RoboticsBrno/RB3201-RBControl/ele/MotorEncoder/v1.1/MotorEncoder.brd

## EAGLE design ele/MotorEncoder/v1.1/MotorEncoder.brd (2018-06-25)

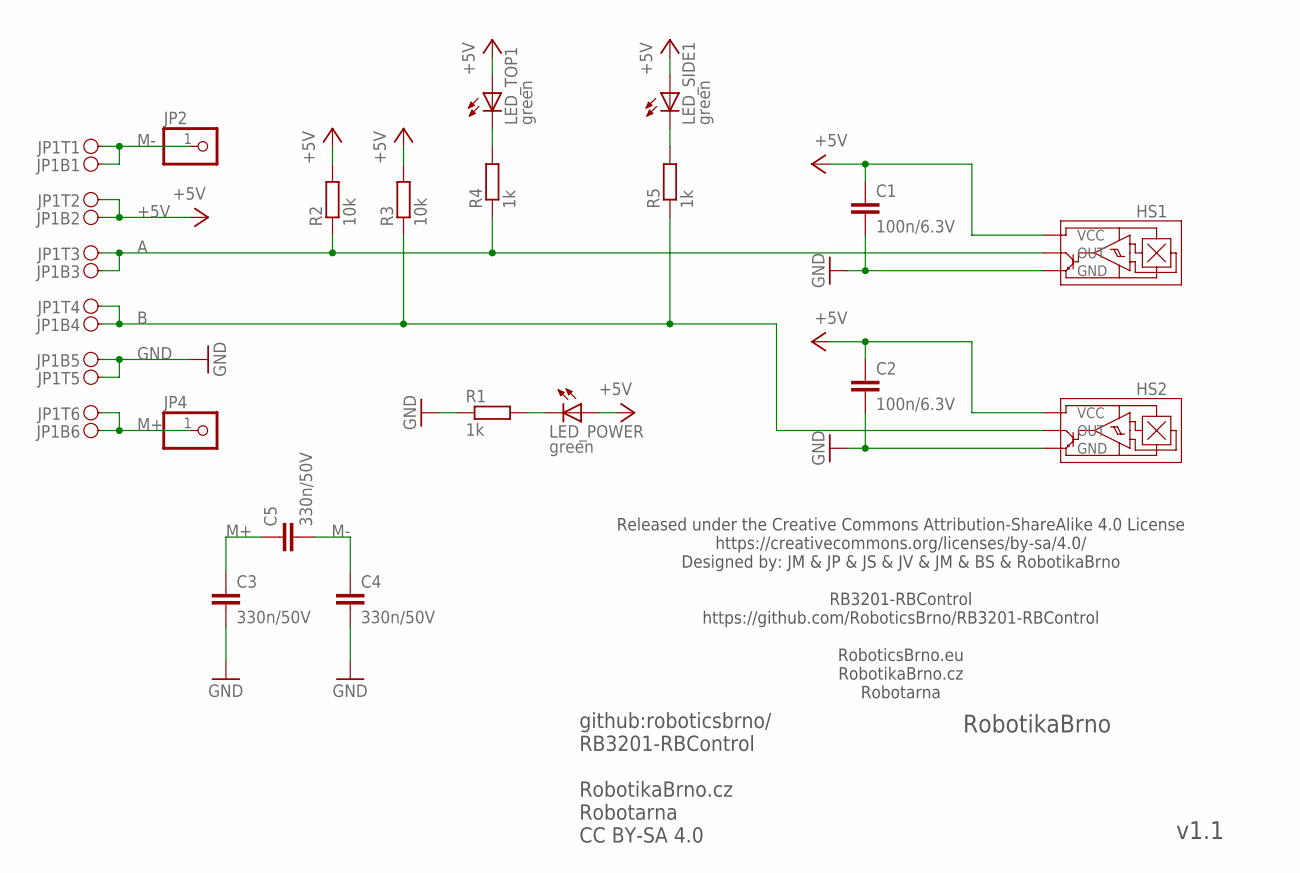
[picture p7: schematic MotorEncoder.sch]

Parts:
C1, C2: 100n/6.3V; C0402
C3, C4, C5: 330n/50V; C0805
HS1, HS2: HALL; SMD/TH
JP1: PINH2X06; PINH2X06SMD
JP2, JP4: PINHD-1X1; 1X01
LED_POWER: green; CHIPLED_0603; DIGIKEY 160-1446-1-ND
LED_SIDE1: green; CHIPLED_0603; DIGIKEY 160-1446-1-ND
LED_TOP1: green; CHIPLED_0603; DIGIKEY 160-1446-1-ND
R1, R4, R5: 1k; R0603
R2, R3: 10k; R0603

Connections:
+5V: C1.1, C2.1, HS1.VCC, HS2.VCC, JP1.B2, JP1.T2, LED_POWER.A, LED_SIDE1.A, LED_TOP1.A, R2.2, R3.2
A: HS1.OUT, JP1.B3, JP1.T3, R2.1, R4.1
B: HS2.OUT, JP1.B4, JP1.T4, R3.1, R5.1
GND: C1.2, C2.2, C3.2, C4.2, HS1.GND, HS2.GND, JP1.B5, JP1.T5, R1.1
LED_POWER: LED_POWER.C, R1.2
LED_SIDE1: LED_SIDE1.C, R5.2
LED_TOP1: LED_TOP1.C, R4.2
M+: C3.1, C5.1, JP1.B6, JP1.T6, JP4.1
M-: C4.1, C5.2, JP1.B1, JP1.T1, JP2.1

Notes on the sheet:
github:roboticsbrno/ RB3201-RBControl RobotikaBrno.cz Robotarna CC BY-SA 4.0
RobotikaBrno
v1.1
Released under the Creative Commons Attribution-ShareAlike 4.0 License https://creativecommons.org/licenses/by-sa/4.0/ Designed by: JM & JP & JS & JV & JM & BS & RobotikaBrno RB3201-RBControl https://github.com/RoboticsBrno/RB3201-RBControl RoboticsBrno.eu RobotikaBrno.cz Robotarna

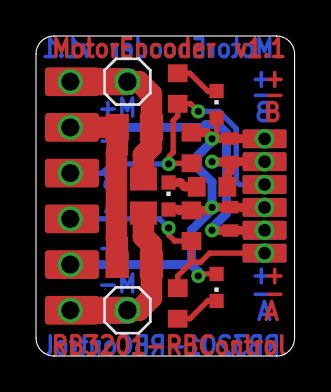
[picture p8: board MotorEncoder.brd from above]

Board: 2 copper layers, 14.4 x 17.8 mm, 18 parts (0 on the bottom side), 9 nets.
