RoboticsBrno/RB3201-RBControl/ele/LegoConnector/v1.0/LegoConnectorX2.brd

## EAGLE design ele/LegoConnector/v1.0/LegoConnectorX2.brd (2018-06-07)

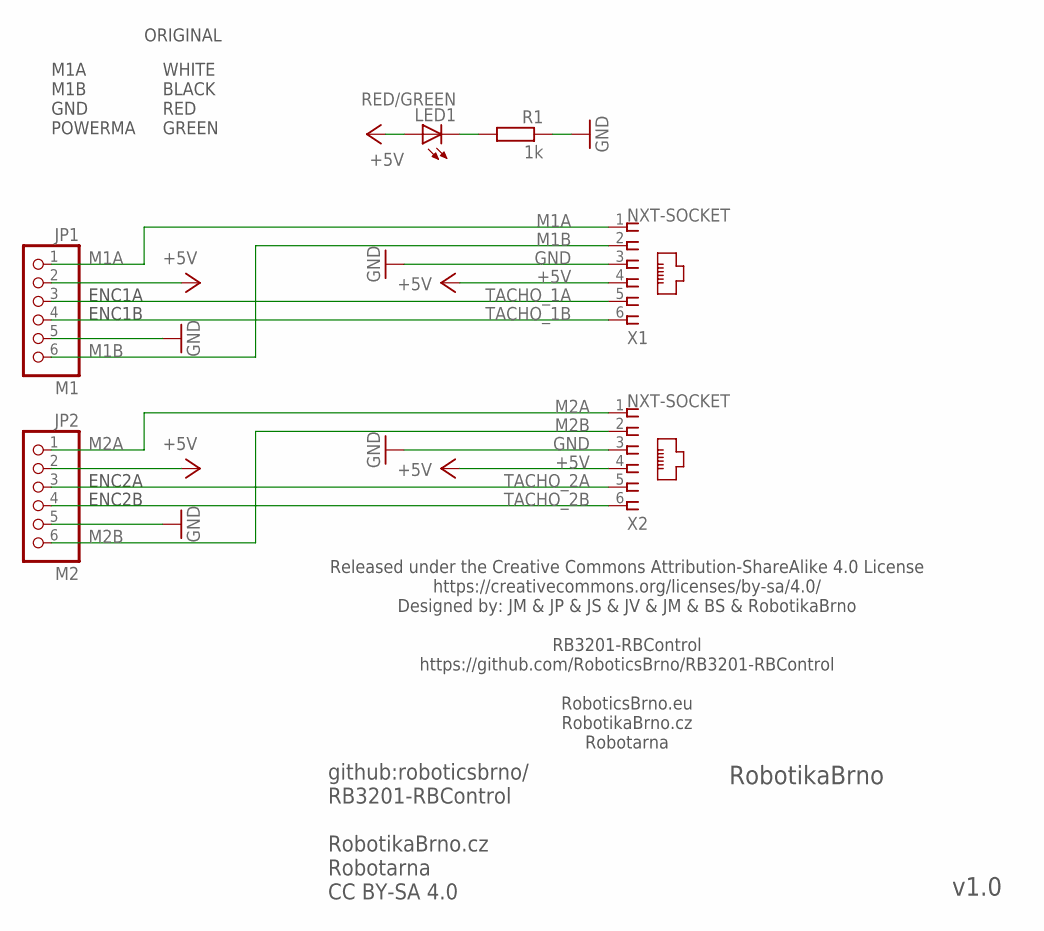
[picture p9: schematic LegoConnectorX2.sch]

Parts:
JP1: M1; 1X06
JP2: M2; 1X06
LED1: RED/GREEN; SML0603
R1: 1k; R0603
X1, X2: NXT-SOCKET

Connections:
+5V: JP1.2, JP2.2, LED1.A, X1.4, X2.4
GND: JP1.5, JP2.5, R1.1, X1.3, X2.3
M1A: JP1.1, X1.1
M1B: JP1.6, X1.2
M2A: JP2.1, X2.1
M2B: JP2.6, X2.2
unnamed: LED1.C, R1.2
TACHO_1A: JP1.3, X1.5
TACHO_1B: JP1.4, X1.6
TACHO_2A: JP2.3, X2.5
TACHO_2B: JP2.4, X2.6

Notes on the sheet:
WHITE BLACK RED GREEN
ORIGINAL
M1A M1B GND POWERMA
ENC1B
ENC1A
ENC2B
ENC2A
github:roboticsbrno/ RB3201-RBControl RobotikaBrno.cz Robotarna CC BY-SA 4.0
RobotikaBrno
v1.0
Released under the Creative Commons Attribution-ShareAlike 4.0 License https://creativecommons.org/licenses/by-sa/4.0/ Designed by: JM & JP & JS & JV & JM & BS & RobotikaBrno RB3201-RBControl https://github.com/RoboticsBrno/RB3201-RBControl RoboticsBrno.eu RobotikaBrno.cz Robotarna

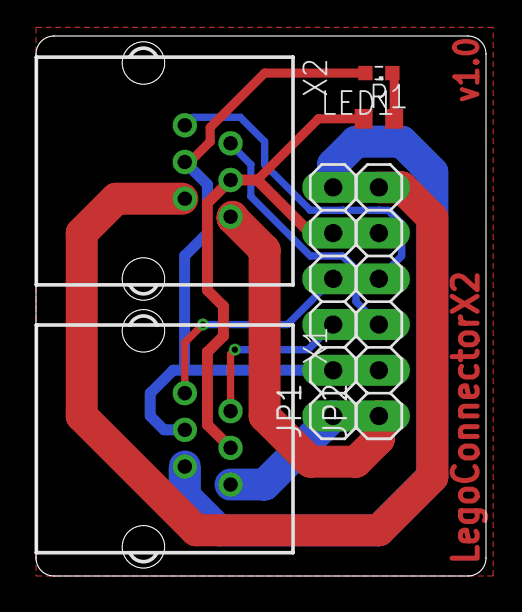
[picture p10: board LegoConnectorX2.brd from above]

Board: 2 copper layers, 25.0 x 30.0 mm, 6 parts (0 on the bottom side), 11 nets.
