RoboticsBrno/RB3201-RBControl/ele/LegoConnector/v1.0/LegoConnectorX1B.brd

## EAGLE design ele/LegoConnector/v1.0/LegoConnectorX1B.brd (2018-06-26)

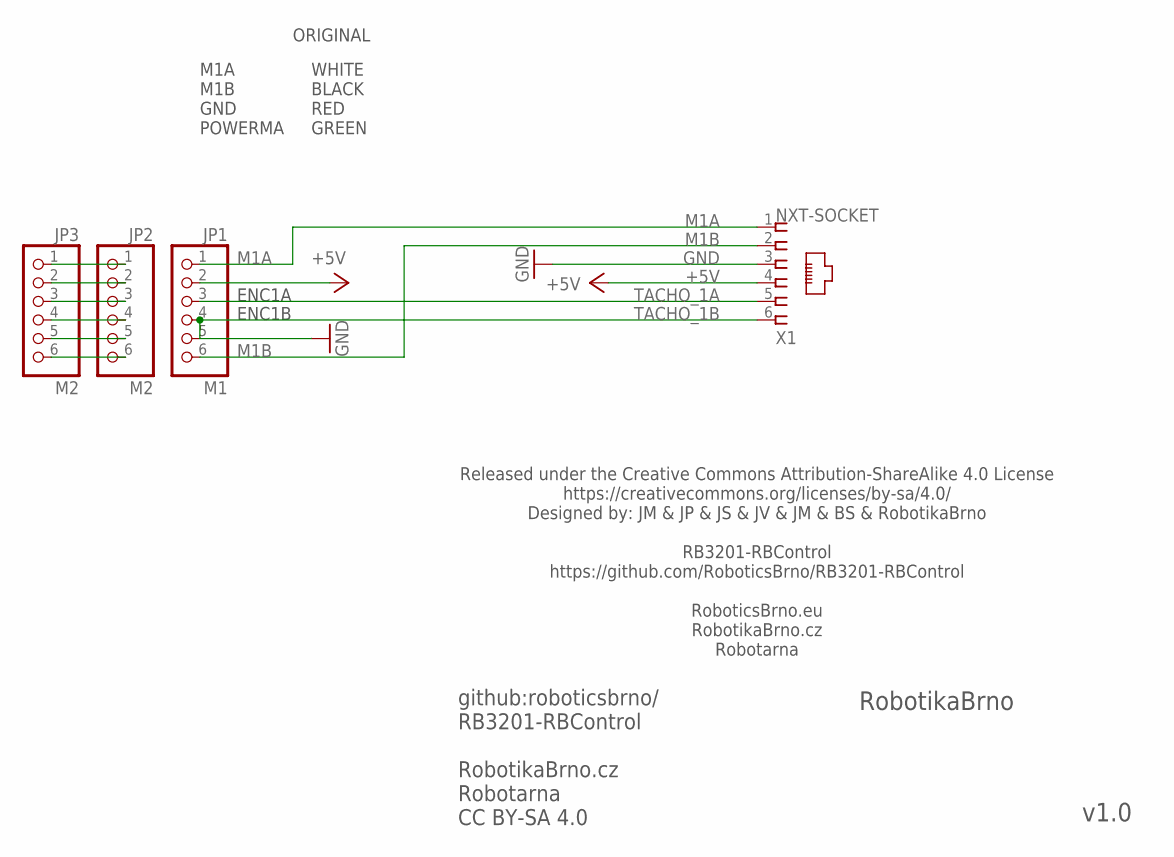
[picture p11: schematic LegoConnectorX1B.sch]

Parts:
JP1: M1; 1X06
JP2, JP3: M2; 1X06
X1: NXT-SOCKET

Connections:
+5V: JP1.2, X1.4
GND: JP1.5, X1.3
M1A: JP1.1, X1.1
M1B: JP1.6, X1.2
unnamed: JP2.1, JP3.1
unnamed: JP2.2, JP3.2
unnamed: JP2.3, JP3.3
unnamed: JP2.4, JP3.4
unnamed: JP2.5, JP3.5
unnamed: JP2.6, JP3.6
TACHO_1A: JP1.3, X1.5
TACHO_1B: JP1.4, X1.6

Notes on the sheet:
WHITE BLACK RED GREEN
ORIGINAL
M1A M1B GND POWERMA
ENC1B
ENC1A
github:roboticsbrno/ RB3201-RBControl RobotikaBrno.cz Robotarna CC BY-SA 4.0
RobotikaBrno
v1.0
Released under the Creative Commons Attribution-ShareAlike 4.0 License https://creativecommons.org/licenses/by-sa/4.0/ Designed by: JM & JP & JS & JV & JM & BS & RobotikaBrno RB3201-RBControl https://github.com/RoboticsBrno/RB3201-RBControl RoboticsBrno.eu RobotikaBrno.cz Robotarna

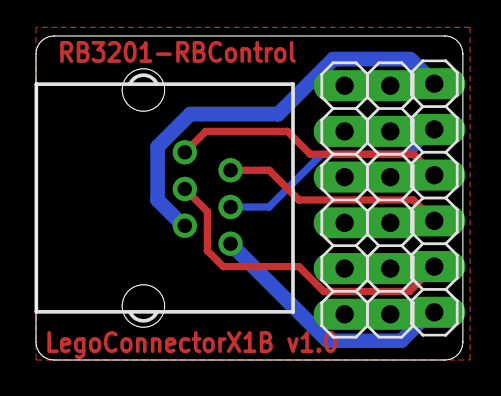
[picture p12: board LegoConnectorX1B.brd from above]

Board: 2 copper layers, 23.7 x 18.0 mm, 4 parts (0 on the bottom side), 12 nets.
